trailcurrentoss/TrailCurrentGodwit/hmi/assets/vehicle/van_top_dark.png

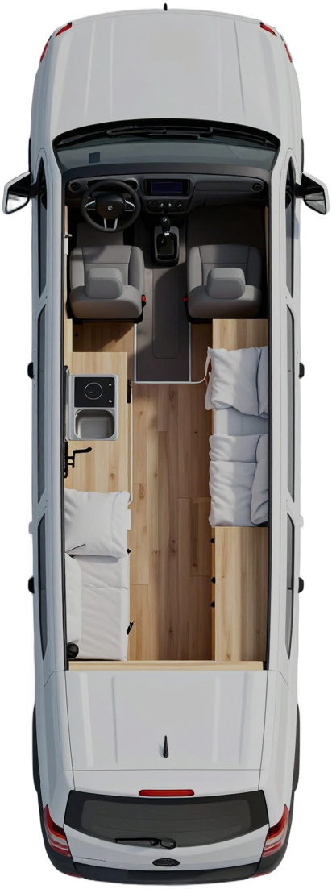
hmi/assets/vehicle/van_top_dark.png
