trailcurrentoss/TrailCurrentGodwit/hmi/assets/water/water_tank_dark.png

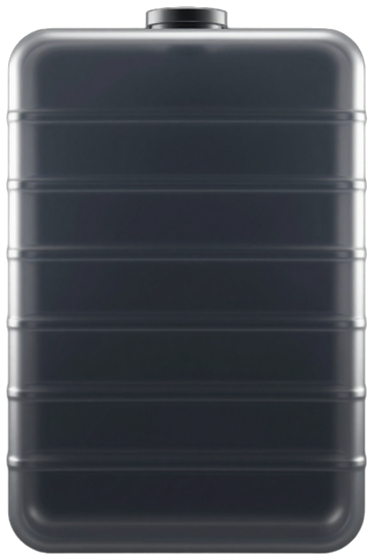
hmi/assets/water/water_tank_dark.png
