trailcurrentoss/TrailCurrentGodwit/os/boards/rpi-cm5/meta-rpi-cm5/templates/feature/cm5-godwit/README_feature_cm5-godwit.md

TrailCurrent Godwit head unit HMI on a Raspberry Pi CM5. Pulls in the
`godwit` feature from meta-godwit and adapts it to the Pi: picks the DRM card
that drives the display, and names the header I2C bus for the GNSS receiver.
