trailcurrentoss/TrailCurrentGodwit/os/boards/rpi-cm5/meta-rpi-cm5/templates/feature/cm5-nvme/README_feature_cm5-nvme.md

Boot a Raspberry Pi CM5 from NVMe: firmware loads the kernel directly
(no U-Boot), the image is partitioned for nvme0n1, and PCIe x1 is enabled.
