trailcurrentoss/TrailCurrentGodwit/DOCS/Design/Dual Encoder Infotainment System/Dual Encoder Head Unit v2.dc.html

Dual Encoder Head Unit

10.1" 1024×600 touch · 2× 1.28" round encoders · 5 addressable RGB LEDs per ring · left-hand drive

{{ g.n }}

Incoming Call {{ simBatteryLabel }} {{ sb.themeLabel }}

{{ nav.dist }}{{ nav.street }}

Then{{ nav.nextStreet }}

{{ nav.eta }}{{ nav.mins }} · {{ nav.miles }}

Zoom {{ nav.zoom }} · {{ nav.view }}

{{ sb.time }}

{{ sb.callTxt }} {{ sb.guideTxt }} {{ turnBanner.dist }} · {{ turnBanner.street }}

{{ sb.out }} {{ sb.soc }}

{{ z.name }} {{ z.knob }}

{{ z.status }}

{{ a.label }}

Fan

{{ z.fanTxt }}

Seat

{{ z.seatTxt }}

{{ z.name }}

{{ t.label }}

{{ radio.band }} {{ radio.genre }}

{{ radio.pillTxt }}

{{ radio.freq }}{{ radio.unit }}

{{ radio.name }}

{{ radio.rt }}

{{ p.f }} {{ p.num }} · {{ p.n }}

{{ k.label }}

{{ media.src }}Paused for call {{ media.title }} {{ media.artist }}

{{ media.pos }}{{ media.dur }}

Up Next{{ media.shuffle }}

{{ q.title }} {{ q.artist }} · {{ q.dur }}

{{ phone.callIni }}

{{ phone.callName }}

{{ phone.callStatus }}

{{ phone.muteLabel }} Left knob · press mutes, hold ends

End Call Right knob · press

Favorites

{{ f.ini }} {{ f.n }}

Recents

{{ r.n }} {{ r.t }}

Battery Level

{{ energy.soc }}{{ energy.remain }} remaining

Solar Input{{ energy.solar }}

Loads{{ energy.loads }}

Charge Status{{ energy.stage }}

{{ r.n }} {{ r.v }}

{{ t.pct }} {{ t.n }} {{ t.gal }}

{{ r.n }} {{ r.v }}

Fresh Remaining {{ water.days }} at 9 gal/day

Pitch {{ level.pitch }} {{ level.pTxt }}

FRONT

{{ level.autoLabel }}{{ level.jackLabel }}

Roll {{ level.roll }} {{ level.rTxt }}

{{ z.n }}{{ z.txt }}

{{ lights.cur.n }} {{ lights.cur.txt }}

{{ lights.cur.hint }}

All Off

{{ cams.cur }} camera feed

{{ c.n }}

{{ cams.dist }}

{{ settings.cur.group }} {{ settings.cur.n }} {{ settings.cur.v }}

{{ r.n }} {{ r.v }}

{{ a.name }}

Answer

{{ incoming.ini }} {{ incoming.name }}{{ incoming.sub }}

Decline

{{ alert.msg }}

{{ toast.msg }}

{{ footL.name }}{{ footL.hint }}

{{ footR.name }}{{ footR.hint }}

TRAILCURRENT

{{ e.label }}

{{ e.value }}{{ e.unit }}

{{ e.sub }}

{{ e.note }}

{{ o.k }}{{ o.v }}

Priority{{ l.n }}

{{ w.k }} {{ w.t }}
