trailcurrentoss/TrailCurrentGodwit/DOCS/Design/Dual Encoder Infotainment System/Dual Encoder Head Unit.dc.html

Dual Encoder Head Unit

10.1" 1024×600 touch · 2× 1.28" round 240×240 encoders with 24-LED RGB rings

Layout {{ o.label }}

Simulate Incoming Call {{ simBatteryLabel }}

{{ sb.time }} {{ sb.out }}

{{ sb.app }}

{{ sb.soc }} LTE

{{ z.name }} {{ z.tgt }}

Airflow

{{ a.label }}

Fan{{ z.fanTxt }}

Seat{{ z.seatTxt }}

Cabin{{ clim.cabin }}

Outside{{ clim.out }}

{{ t.label }}

{{ t.label }}

{{ z.name }} Cabin {{ clim.cabin }} · Knob {{ z.knob }}

{{ a.label }}

Fan {{ z.fanTxt }}

Seat {{ z.seatTxt }}

{{ radio.band }} {{ radio.genre }}

{{ radio.freq }}{{ radio.unit }}

{{ radio.name }}

{{ radio.rt }}

{{ k.label }}

Presets

{{ p.num }} · {{ p.band }} {{ p.f }} {{ p.n }}

{{ radio.freq }}{{ radio.unit }}

{{ radio.name }} · {{ radio.genre }}

{{ k.label }}

Stations · {{ radio.band }}

{{ s.f }}{{ s.n }}{{ s.g }}

Presets

{{ p.num }}{{ p.f }}{{ p.n }}

{{ media.title }}

{{ media.artist }} · {{ media.src }}

{{ media.pos }}{{ media.dur }}

Up NextShuffle {{ media.shuffle }}

{{ q.n }} {{ q.title }} · {{ q.artist }} {{ q.dur }}

{{ media.src }}

{{ media.title }}

{{ media.artist }}

{{ media.pos }}

{{ media.dur }}

{{ q.n }} · {{ q.dur }}{{ q.title }}{{ q.artist }}

{{ nav.dist }}{{ nav.street }}

Then{{ nav.nextStreet }}

Zoom {{ nav.zoom }} · {{ nav.view }}

{{ nav.eta }}{{ nav.mins }} · {{ nav.miles }}

Zoom {{ nav.zoom }} · {{ nav.view }}

Arrive

{{ nav.eta }}

{{ nav.mins }} · {{ nav.miles }}

{{ r.street }}{{ r.label }} · {{ r.dist }}

{{ phone.callIni }}

{{ phone.callName }}

{{ phone.callStatus }}

{{ phone.leftLabel }} {{ phone.rightLabel }}

Recents

{{ r.n }}{{ r.type }} {{ r.t }}

{{ phone.selIni }}

{{ phone.selName }}

{{ phone.selNum }}

Call

{{ f.ini }} {{ f.n }}

Selected

{{ phone.selName }}

{{ phone.selNum }}

Call

Power Flow

Solar InputMPPT · {{ energy.stage }}

{{ energy.solar }}

Battery Level{{ energy.volts }} · {{ energy.amps }}

{{ energy.soc }}

LoadsTime Remaining {{ energy.remain }}

{{ energy.loads }}

Inverter {{ energy.inv }}

Charge Limit {{ energy.limit }}

Circuits

{{ c.n }}{{ c.w }} {{ c.st }}

Battery Level

{{ energy.soc }}

Time Remaining

{{ energy.remain }}

Inverter {{ energy.inv }} · Shore {{ energy.shore }}

Solar Input

{{ energy.solar }}

Loads

{{ energy.loads }}

Voltage

{{ energy.volts }}

Charge Limit

{{ energy.limit }}

{{ c.n }} {{ c.st }}

{{ t.n }}

{{ t.pct }} {{ t.gal }}

Pump · {{ water.pump }} Water Heater{{ water.set }}{{ water.heater }}

Water Tanks

{{ t.n }}

{{ t.pct }}{{ t.gal }}

Fresh Remaining

{{ water.days }}

at 9 gal/day

Pump · {{ water.pump }} Heater {{ water.set }} · {{ water.heater }}

FRONT

{{ level.status }}

Pitch · Left Knob

{{ level.pitch }}

{{ level.pTxt }}

Roll · Right Knob

{{ level.roll }}

{{ level.rTxt }}

{{ level.autoLabel }}

FRONT Jacks {{ level.jacks }} {{ level.short }}

{{ c.n }}{{ c.v }}

Pitch

{{ level.pitch }}

Roll

{{ level.roll }}

{{ level.autoLabel }}

{{ z.n }}{{ z.txt }}

{{ z.n }}

{{ z.pct }} {{ z.st }}

Camera feed · {{ cams.cur }}

{{ cams.cur }} · Live

{{ cams.zoom }}

{{ c.n }}

Camera feed

{{ c.n }}

{{ i.n }}{{ i.v }}

{{ settings.cur.n }}

{{ settings.cur.v }}

{{ settings.cur.hint }}

{{ i.n }} {{ i.v }}

{{ a.name }}

{{ alert.msg }}

{{ toast.msg }}

{{ footL.name }}{{ footL.hint }}

{{ d.name }}

{{ footR.name }}{{ footR.hint }}

{{ e.label }}

{{ e.value }}{{ e.unit }}

{{ e.sub }}

{{ e.keys }}

Scroll or drag a knob to turn · Click to press · Hold to long-press
