trailcurrentoss/TrailCurrentGodwit/DOCS/boards/dragon-q6a/godwit-header-pinout.png

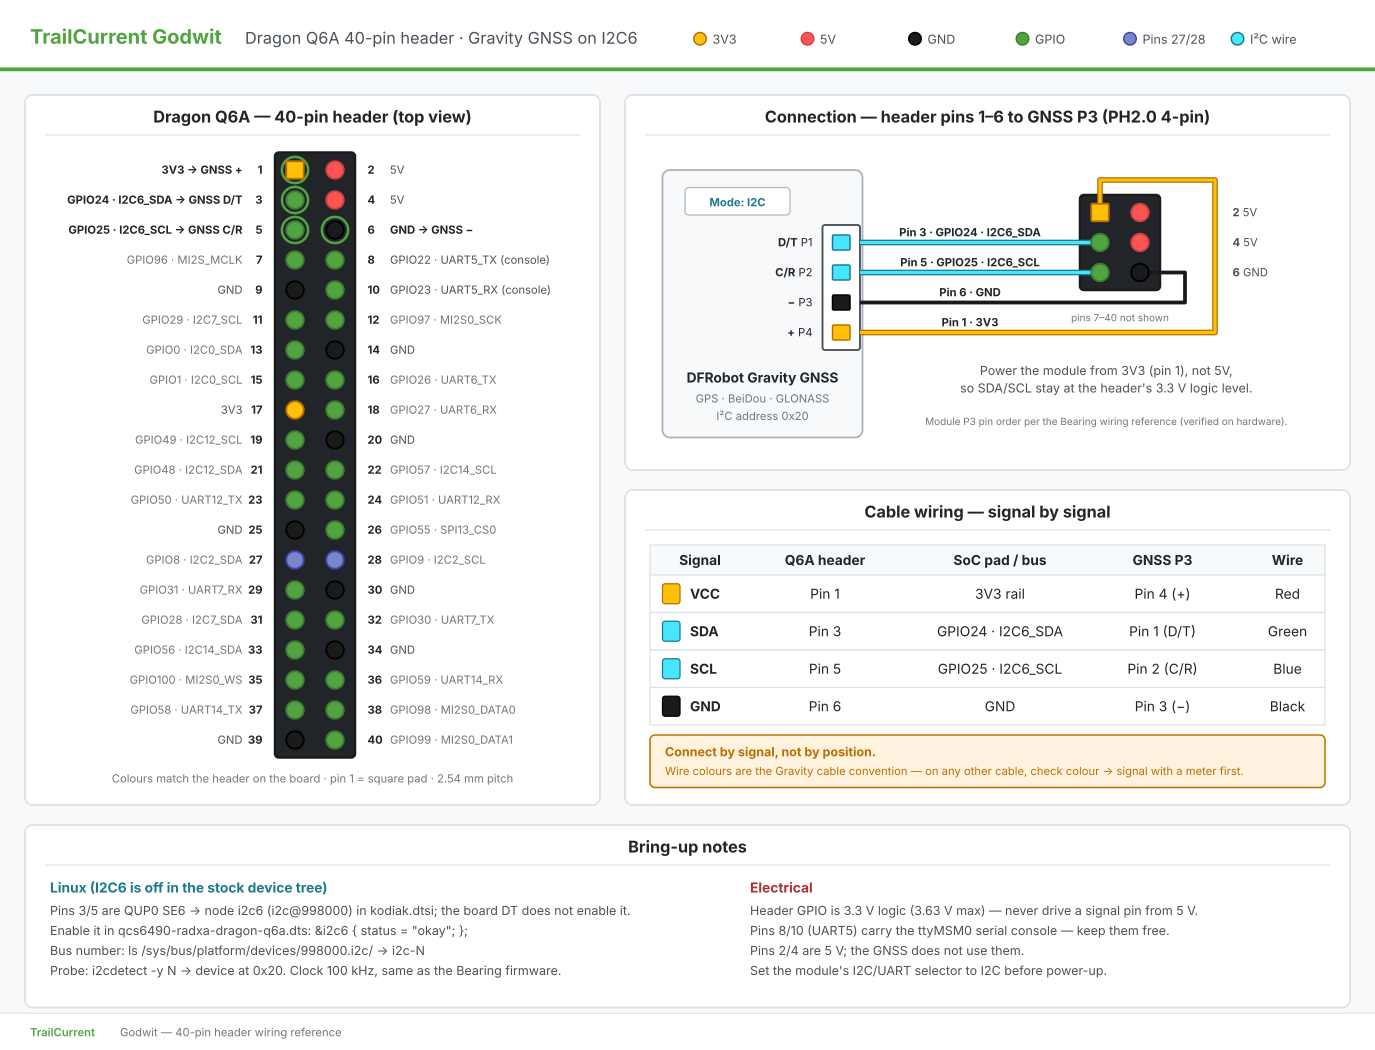
DOCS/boards/dragon-q6a/godwit-header-pinout.png
