trailcurrentoss/TrailCurrentGodwit/DOCS/Design/Dual Encoder Infotainment System/assets/map.png

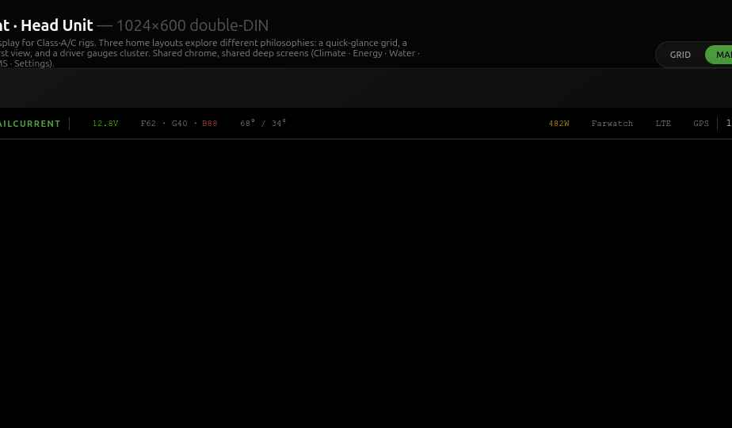
DOCS/Design/Dual Encoder Infotainment System/assets/map.png
