trailcurrentoss/TrailCurrentGodwit/hmi/assets/fx/glow_air.png

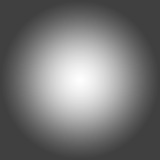
hmi/assets/fx/glow_air.png
