trailcurrentoss/TrailCurrentGodwit/hmi/assets/fx/glow_cool.png

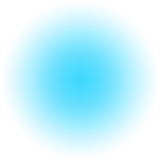
hmi/assets/fx/glow_cool.png
