trailcurrentoss/TrailCurrentGodwit/hmi/assets/shadow-lg.png

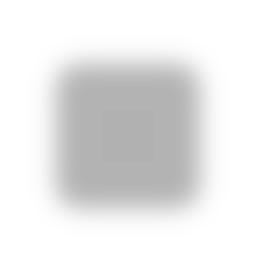
hmi/assets/shadow-lg.png
