trailcurrentoss/TrailCurrentGodwit/hmi/assets/shadow.png

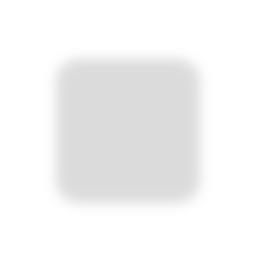
hmi/assets/shadow.png
