trailcurrentoss/TrailCurrentGodwit/hmi/assets/water/water_tank_light.png

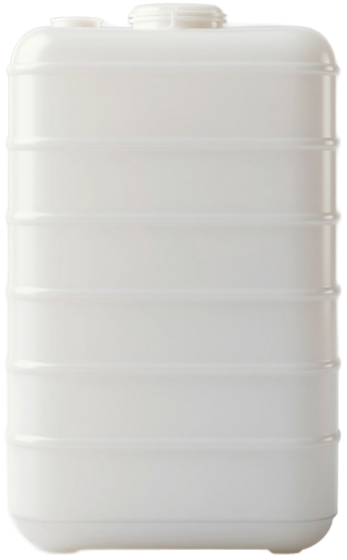
hmi/assets/water/water_tank_light.png
