trailcurrentoss/TrailCurrentGodwit/CAD/exports/Godwit_Shell.step

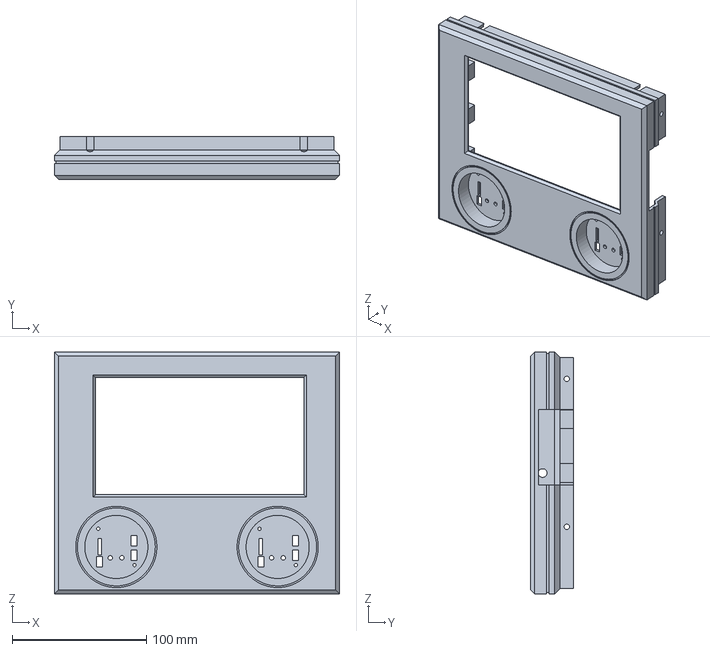
[picture p10: CAD file, 2026-10-24]
CAD/exports/Godwit_Shell.step
212.0 x 32.0 x 180.0 mm
