trailcurrentoss/TrailCurrentGodwit/CAD/TrailCurrentGodwitEnclosure.FCStd

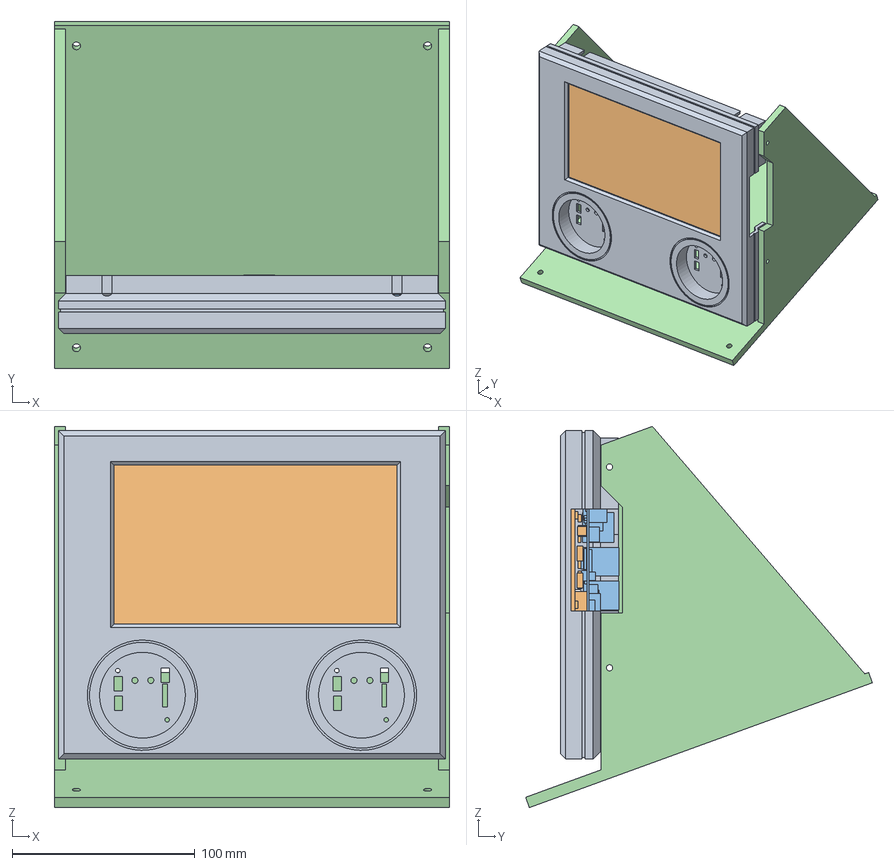
[picture p11: CAD file, 2026-10-24]
CAD/TrailCurrentGodwitEnclosure.FCStd
216.4 x 190.0 x 208.8 mm
Ref_Display_Blocks
Ref_RadxaQ6A_Blocks
DeskStand
