trailcurrentoss/TrailCurrentGodwit/CAD/exports/Godwit_DeskStand.step

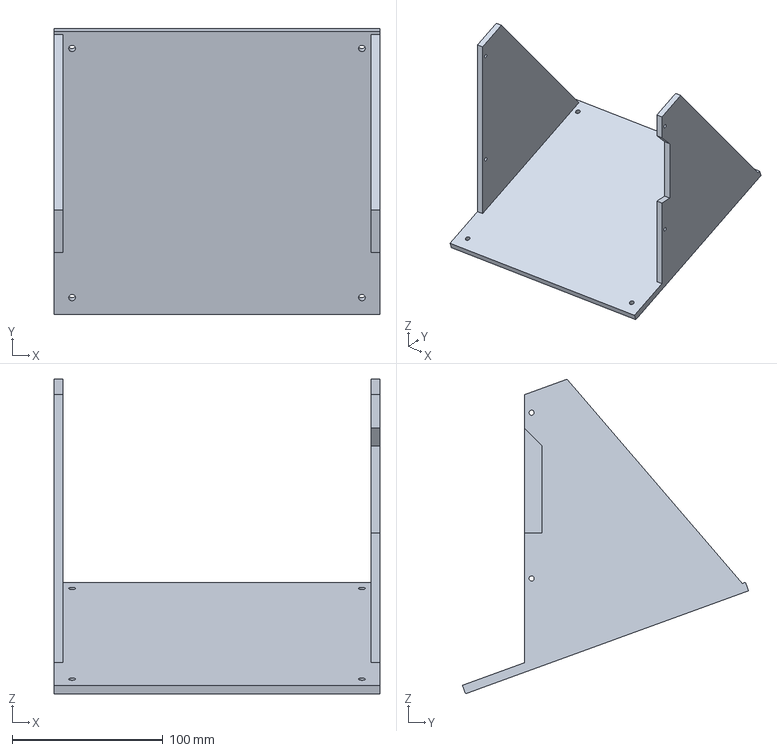
[picture p12: CAD file, 2026-10-24]
CAD/exports/Godwit_DeskStand.step
216.4 x 190.0 x 208.8 mm
