trailcurrentoss/TrailCurrentGodwit/CAD/exports/Godwit_DeskStand_L.step

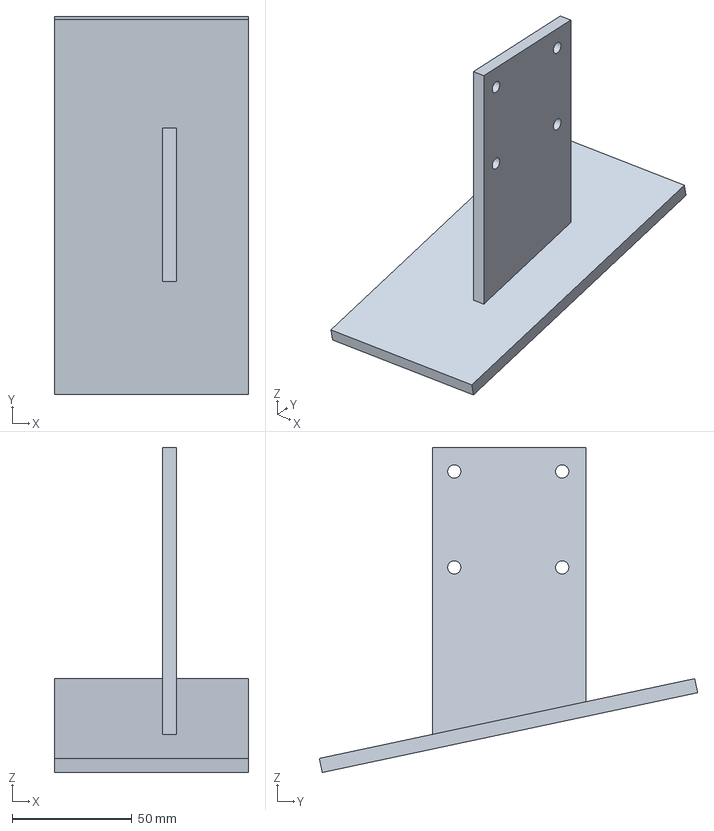
[picture p13: CAD file, 2026-10-22]
CAD/exports/Godwit_DeskStand_L.step
81.0 x 157.8 x 135.5 mm
