trailcurrentoss/TrailCurrentGodwit/CAD/exports/Godwit_RearPlate.step

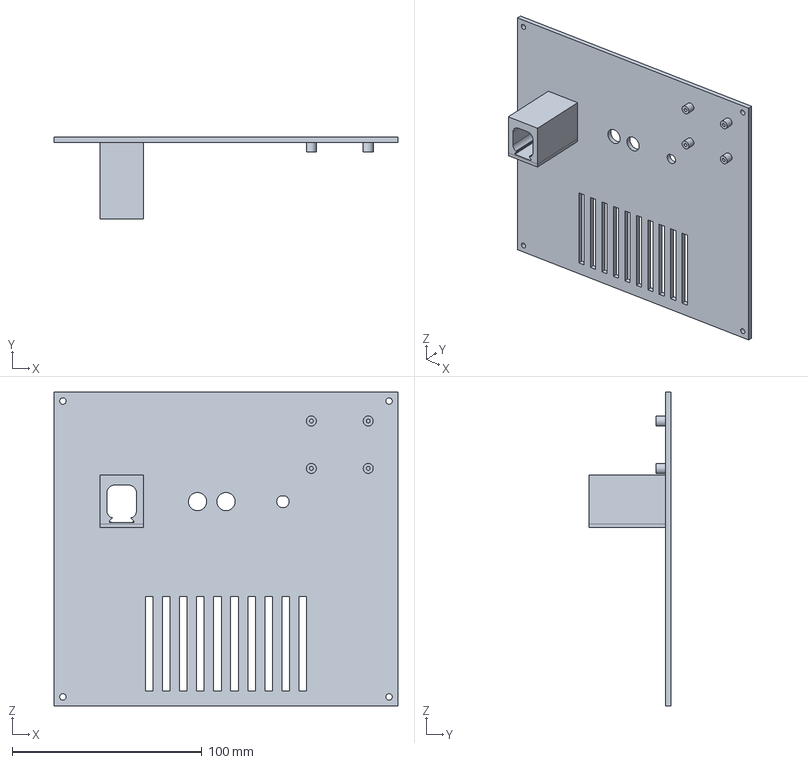
[picture p14: CAD file, 2026-10-22]
CAD/exports/Godwit_RearPlate.step
181.4 x 43.2 x 165.4 mm
