trailcurrentoss/TrailCurrentGodwit/CAD/exports/Godwit_DisplayClamp.step

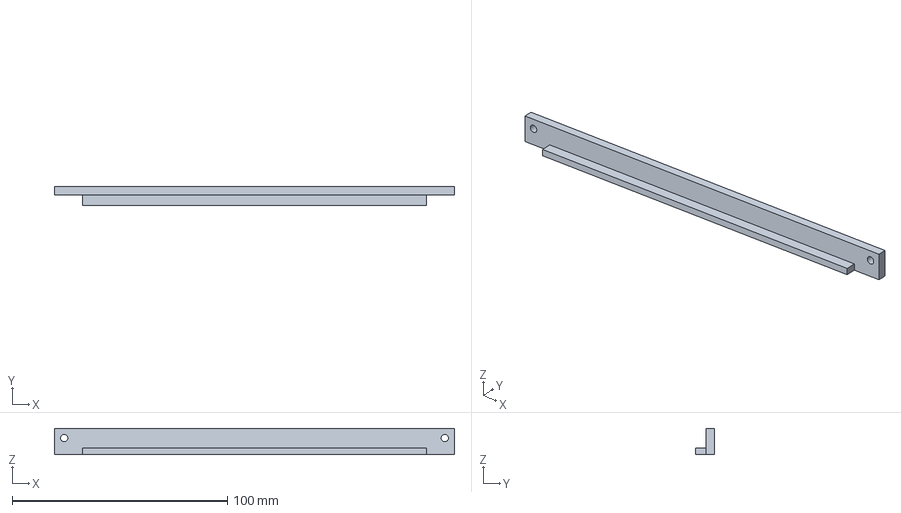
[picture p15: CAD file, 2026-10-22]
CAD/exports/Godwit_DisplayClamp.step
186.0 x 8.80 x 12.2 mm
