trailcurrentoss/TrailCurrentGodwit/(list of files, cad)

Other CAD files:
CAD/exports/Godwit_DeskStand_R.step
CAD/exports/Godwit_DeskStand.stl
CAD/exports/Godwit_DeskStand_L.stl
CAD/exports/Godwit_DeskStand_R.stl
CAD/exports/Godwit_DisplayClamp.stl
CAD/exports/Godwit_RearPlate.stl
CAD/exports/Godwit_Shell.stl
