trailcurrentoss/TrailCurrentGodwit/(commit log)

2026-10-22 Basics up and running one rotary encoder functioning
2026-10-23 Fixing a bug that would cause temporary HDMI on boot to prevent GUI when connection is regained. Flipping screen on knobs to accomodate case design.
2026-10-24 Updates to enclosure
2026-10-24 Build for the Raspberry Pi CM5 as well as the Dragon Q6A, one folder per board
2026-10-24 Use simple interface blocks for the board, display, encoder and connector references
2026-10-24 Add the driver safety notice, About & Legal screen and license texts
2026-10-24 Pick up Wi-Fi when its driver loads after the HMI starts
2026-10-24 Update enclosure exports and add the single desk stand
2026-10-25 Stop climate airflow when the fan is turned off by touch
2026-10-25 Stop the reconnect timer breaking music from returning phones
    Once a minute the HMI called Device1.Connect on any paired phone that
    was not connected. That opens every profile from the head unit's end,
    A2DP included. An iPhone coming back into range opens A2DP from its
    end at the same time; the two setups collided ("avdtp: Transaction
    label doesn't match") and music started, then went silent with the
    phone still connected. The same page also reconnected phones that had
    been disconnected on purpose, which then refused and dropped the link.
    Page a returning phone for hands-free only, one request at a time, and
    let the phone start music itself. If it has no media transport 10 s
    after connectin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
2026-10-25 Draw the driver's climate effects stronger to match the passenger's
    The steering wheel and lighter trim under the driver's seat and footwell wash out the glow and airflow streaks, so the same settings looked weaker on that side. Scale the driver's effects by 1.25.
2026-10-25 Make the climate glows follow settings without leaving the screen
    The seat, footwell and defrost glows faded with a Behavior on opacity, but their opacity also followed the shared breathing pulse, which changes every frame. The fade restarted every frame and never got anywhere, so a glow stayed hidden until the screen was left and the pulse stopped. Fade a level driven only by the setting, and apply the pulse on top of it.
